ClimbSnail/SnailHeater/Doc/other.md

### 华为24V电源
原24V的R16为4322（43.2k）
20V的R16为2702（27k）

### 电源纹波
华为5.284  5.295v  空载浮动0.015
普通 5.292 5.304v  空载浮动0.016

### SnailHeater
接负载3A

---
##### 第一次
可调电源
［24V电源输入端］
空载: 230mv
1A 240mv
2A 280mv
3A 350mv
4A 370mv
5A 700mv

[可调电源输出端]
空载: 40mv
1A 60mv
2A 60mv
3A 70mv
4A 140mv
5A 150mv

---
##### 第二次
100mv  20ms

输入电源
空载 330mv
9V3A 500mv

可调电源
空载 230mv
9V3A  300mv

### 磁铁触发测试
* 6*10mm 左右各两个（共4个），完全能触发，但底座不能完美安装上。
* 6*10mm 左右各一个（共2个），80%角度都能触发，能安装上。
* 6*15mm 左右各一个，能完美安装且完全能触发。
* 8*12mm 左右各一个，能完美安装且完全能触发。
* 15*3mm圆形磁铁左右各一个，能完美安装且完全能触发。

### 烙铁架
* 原烙铁架 70*160mm
* 现烙铁架 73*160mm

### 组装注意事项
【电源板】
1. 背面标有“填锡孔”字样的孔需要用锡填充。
2. 侧边贴外壳的三脚的二极管，需要事先调好高度。(组装需要拧螺丝)
3. 板子上插接的小电源需要使用绝缘胶固定。
4. 插件的小电源旁边有个位号“SB3”的短接焊盘，需要短接上。
5. 注意电源输出端子的连接线，GND黑色，24V红色，12v白色

【屏幕板】
1. 康铜丝跳线器件焊接的时候 顶端需要比板子边缘略高一点点，1mm左右就行
2. 旋钮编码器需要弯脚，然后焊接在屏幕板上

【驱动板】
1. 背面标有“填锡孔”字样的孔需要用锡填充。

【接线板】
1. 板子是两部分，中间需要掰开（最好用剪线钳压一下，避免掰坏铜皮）。一个是类似方形的小板，另一部分是长条形的。
2. 两个GX16-8航空头中间的第8脚都需要用2.5cm的硅胶线连接到各自附近的通孔上。

【组装注意】
1. 机壳的青稞纸不要盖住螺丝孔位。
2. 驱动板的两个可控硅，需要通过垫氧化铝散热片以及绝缘粒方可拧上螺丝。
3. 驱动板与机壳安装时，驱动板右上角固定螺丝不要拧太紧（容易让板子变形）。拧上螺丝后需要打点胶固定螺丝。
4. 驱动板的220V接线座，拧完螺丝后，最好在螺丝上打点胶，以免螺丝运输过程中松动。

### 加热台发热芯要求
1. 把1234号孔心距边缘5mm
2. 1、2号孔相距13cm  3、4号孔也是1、3cm
3. 1、3号孔相距8cm  2、4号孔也是8cm

然后不要打金黄色的固定环  固定的话用订书钉就行

### 烙铁分度表
注：ZT-X万用表实测电压比以下高10mv左右。以下电压均为热电偶放大201倍后的电压
##### JBC245-759 单次实测
温度 | 5 | 10 | 15 | 20 | 25 | 30 | 35 | 40 | 45 | 50 | 55 | 60 | 65 | 70 | 75 | 80 | 85 | 90 | 95 | 100
:-: | :-: | :-: | :-: | :-: | :-: | :-: | :-: | :-: | :-: | :-: | :-: | :-: | :-: | :-: | :-: | :-: | :-: | :-: | :-: | :-:
0 | 5 | 5 | 5 | 5 | 5 | 5 | 5 | 5 | 5 | 5 | 5 | 5 | 5 | 5 | 5 | 5 | 5 | 5 | 5 | 5
100 | 5 | 5 | 5 | 5 | 5 | 5 | 5 | 5 | 5 | 5 | 5 | 5 | 5 | 5 | 5 | 5 | 5 | 5 | 5 | 5
200 | 5 | 5 | 5 | 5 | 5 | 5 | 5 | 5 | 5 | 5 | 5 | 5 | 5 | 5 | 5 | 5 | 5 | 5 | 5 | 5
300 | 5 | 5 | 5 | 5 | 5 | 5 | 5 | 5 | 5 | 5 | 5 | 5 | 5 | 5 | 5 | 5 | 5 | 5 | 5 | 5
400 | 5 | 5 | 5 | 5 | 5 | 5 | 5 | 5 | 5 | 5 | 5 | 5 | 5 | 5 | 5 | 5 | 5 | 5 | 5 | 5
500 | 5 | 5 | 5 | 5 | 5 | 5 | 5 | 5 | 5 | 5 | 5 | 5 | 5 | 5 | 5 | 5 | 5 | 5 | 5 | 5

##### JBC245-759 稳定实测
温度 | 50 | 100 | 150 | 200 | 250 | 300 | 350 | 400 | 450
:-: | :-: | :-: | :-: | :-: | :-: | :-: | :-: | :-: | :-: 
C245-908 | 88 | 333 | 580 | 840 | 1100 | 1375 | 1663 | 1930 | 2160
C245-759 | 94 | 347 | 597 | 863 | 1138 | 1410 | 1680 | 1945 | 
C210-006 | 42 | 129 | 225 | 343 | 450 | 574 | 700 | 826 | 959
