ClimbSnail/SnailHeater/Doc/重量统计.md

高频焊台总共1350g

#### 外壳 228g
#### pcba（不含线） 75.9g

#### 整体主机 537.1g

#### 风枪手柄 220g
#### 风枪架 46.4g

#### 加热板: 
* 上板 242g 
* 下板58g 
* 发热心45.4g 
* 4套大螺丝（含螺母）60g  
* 7枚小螺丝6.1g  
* 4个木墩5.2g
* 热电偶4g

#### 烙铁:
* JBC245烙铁芯6g
* T12烙铁芯7.3g
* JBC210烙铁芯2.2g
* JBC245手柄65.3g(含1.3m线、航空插)
* T12手柄77.5g（含1.2m线、航空插）
* JBC210手柄15.9g（不含线和航空头）

#### 点焊机
* 3000UF*2电容  1010g

#### 24V大电源  146g
