ClimbSnail/SnailHeater/Tool/SnailManager/tools/README.md

# 独立工具

这些脚本不属于四个 GUI 入口的运行依赖，可按需单独执行。

- `cli/SnailHeater_Tool.py`：命令行刷机工具实现；建议从根目录的兼容入口启动。
- `wallpaper/createWallpaperClean.py`：生成空白壁纸文件。
