ClimbSnail/SnailHeater/Tool/SnailManager/requirements/requirements_webui_venv.txt

Pillow~=9.5.0
pyserial~=3.5
pyyaml==6.0
requests==2.26.0
pyinstaller==5.5.0
esptool==4.7.0
setuptools==49.2.1

# 现代 WebUI 本地服务与 Windows 容器
fastapi>=0.115,<1
uvicorn>=0.30,<1
pywebview>=5.4,<7
pypng==0.20220715.0
lz4==4.3.3
# MP4 转 RTTTL：沿用旧版 pYIN 音高检测与 BPM 量化算法
numpy==1.24.4
# librosa==0.10.2.post1
# QT_Tool 保留的独立 MIDI → RTTTL 转换脚本
mido==1.3.3
