ClimbSnail/SnailHeater/Tool/SnailManager/requirements/requirements_pyside_py38_venv.txt

altgraph==0.17.5
bitarray==3.8.0
bitstring==4.4.0
certifi==2026.2.25
cffi==1.17.1
charset-normalizer==2.0.12
cryptography==46.0.6
ecdsa==0.19.2
esptool==4.7.0
idna==3.11
intelhex==2.3.0
packaging==26.0
pefile==2024.8.26
Pillow==9.5.0
pyinstaller==5.5
pyinstaller-hooks-contrib==2026.3
pyserial==3.5
PySide2==5.15.2.1
pywin32-ctypes==0.2.3
PyYAML==6.0
reedsolo==1.7.0
requests==2.26.0
shiboken2==5.15.2.1
six==1.17.0
tibs==0.5.7
typing_extensions==4.13.2
urllib3==1.26.20
fastapi>=0.115,<1
uvicorn>=0.30,<1
pywebview>=5.4,<7
pypng==0.20220715.0
lz4==4.3.3

# MP4 转 RTTTL：沿用旧版 pYIN 音高检测与 BPM 量化算法
# numpy==1.24.4
# librosa==0.10.2.post1
# QT_Tool 保留的独立 MIDI → RTTTL 转换脚本
mido==1.3.3
