ClimbSnail/SnailHeater/Tool/QT_Tool/ToRtttl.md

## 转码须知
RTTTL和MIDI文件都不是音频编码文件，无法从mp3、wav等无损转化。

使用RTTTL的人较少，由于玩音乐钢琴的人多，故使用MIDI会多。

MIDI可以接近无损转为RTTTL（损失部分本身就是rtttl不支持的），可将wav、mp3文件先转成MIDI文件，然后再将MIDI转RTTTL。

## 可以直接下载现成的RTTTL文件
1. https://rtttl.ringtone.cc 最全的RTTTL铃声库
2. http://www.projectrtttl.com 老牌RTTTL网站，资源丰富
3. https://1j01.github.io/rtttl.js/ 
4. http://microblocks.fun/mbtest/NokringTunes.txt

##### 现成的RTTTL文本
* 诺基亚经典铃声 Nokia:d=4,o=5,b=180:8e6,8d6,f#,g#,8c#6,8b,d,e,8b,8a,c#,e,a
* 超级马里奥主题曲（片段） Mario:d=4,o=5,b=100:16e6,16e6,32p,8e6,16c6,8e6,8g6,8p,8g
* 小星星 Twinkle:d=4,o=5,b=120:8c,8c,8g,8g,8a,8a,4g,8f,8f,8e,8e,8d,8d,4c
* 生日快乐 Birthday:d=4,o=5,b=125:8c,8c,8d,8c,8f,8e,4c,8c,8c,8d,8c,8g,8f
* 简单蜂鸣器测试音 Test:d=4,o=5,b=60:8c5,8d5,8e5,8f5,8g5,8a5,8b5,8c6

## 可以直接下载现成的MIDI文件
1. MidiWorld (midiworld.com) 全球最大MIDI库之一，超过10万首，直接下载，无需注册
2. BitMidi (bitmidi.com) 现代界面，易搜索，完全免费，无下载限制
3. 

## Rtttl播放测试
1. https://github.com/ImSkully/rtttl-web-composer 项目自带的 https://rtttl.skully.tech/ web页面可以播放和编辑
2. https://github.com/adamonsoon/rtttl-play 开源项目可直接运行，但源码有点问题，需要根据Issues中参考修改，或者使用已经修改好的代码包

## MIDI文件测试播放
任意视频播放器均可
