ClimbSnail/SnailHeater/Doc/V2.0功率板修改/功率板电容原始状态.jpg

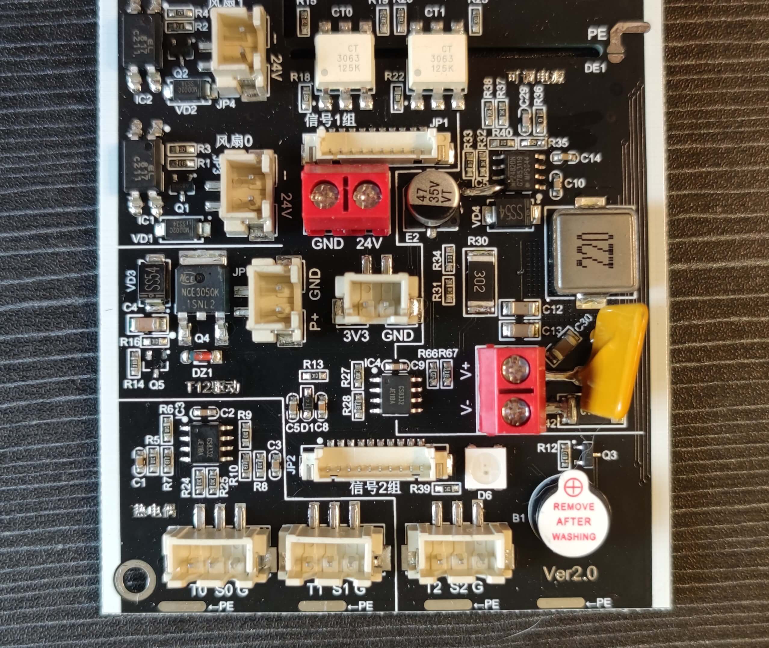
Doc/V2.0功率板修改/功率板电容原始状态.jpg
