ClimbSnail/SnailHeater/Doc/V2.0功率板修改/电容刮阻焊.jpg

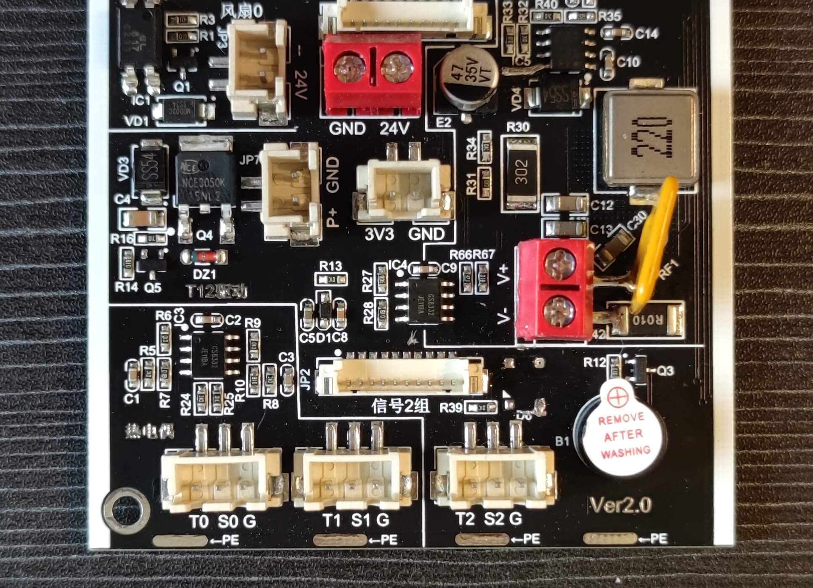
Doc/V2.0功率板修改/电容刮阻焊.jpg
