ClimbSnail/SnailHeater/Doc/V2.0功率板修改/电容焊接状态.jpg

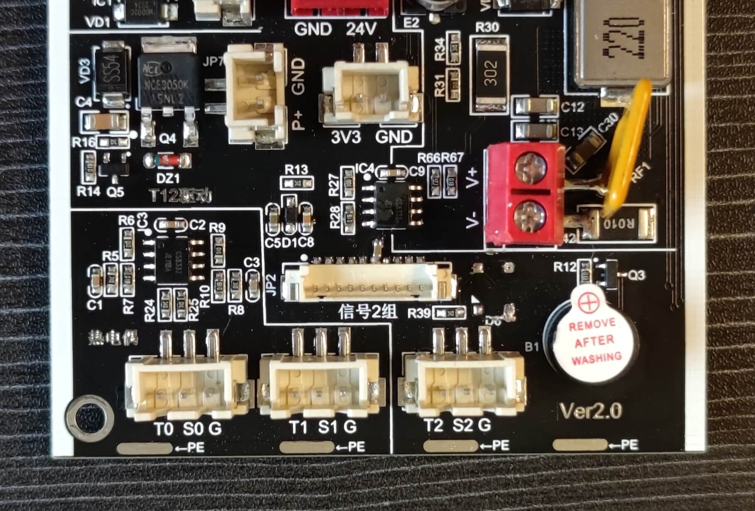
Doc/V2.0功率板修改/电容焊接状态.jpg
