ClimbSnail/SnailHeater/Doc/二车青稞纸定制.png

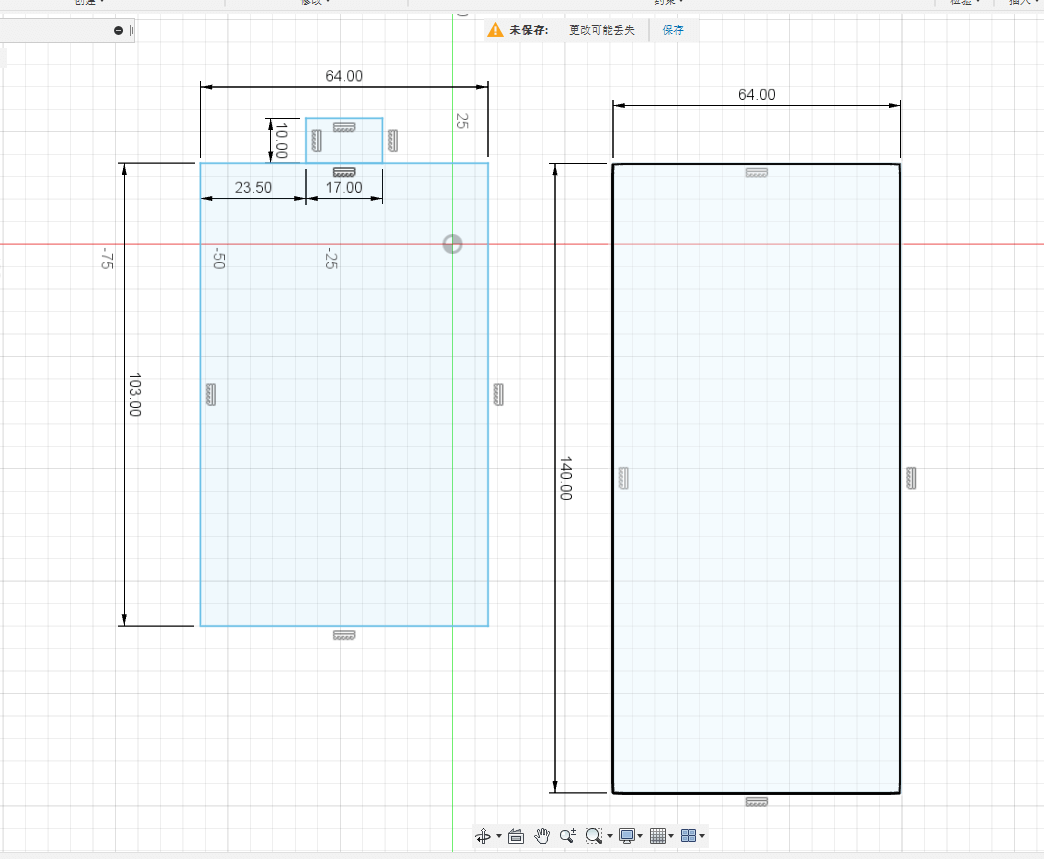
Doc/二车青稞纸定制.png
