ClimbSnail/SnailHeater/Doc/蜗牛台使用说明书/配套管理工具.png

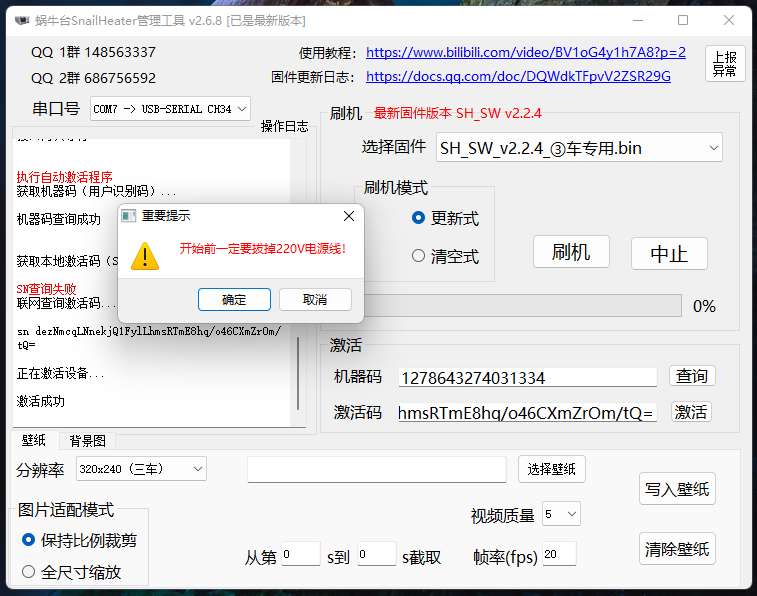
Doc/蜗牛台使用说明书/配套管理工具.png
