ClimbSnail/SnailHeater/Images/ico/方波-01.png

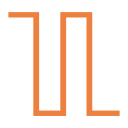
Images/ico/方波-01.png
