ClimbSnail/SnailHeater/Images/ico/正弦线.png

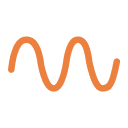
Images/ico/正弦线.png
