ClimbSnail/SnailHeater/Images/SnailHeaterUI_Simulator.png

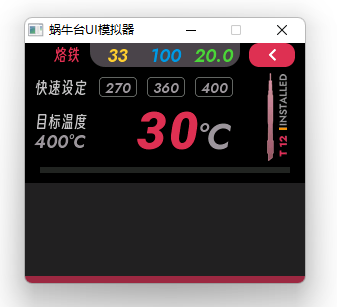
Images/SnailHeaterUI_Simulator.png
