ClimbSnail/SnailHeater/Images/全套控制板.jpg

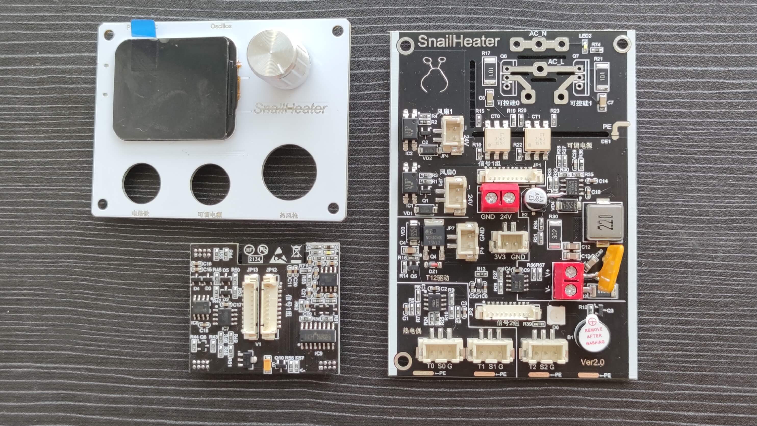
Images/全套控制板.jpg
