ClimbSnail/SnailHeater/Images/整机俯视图.jpg

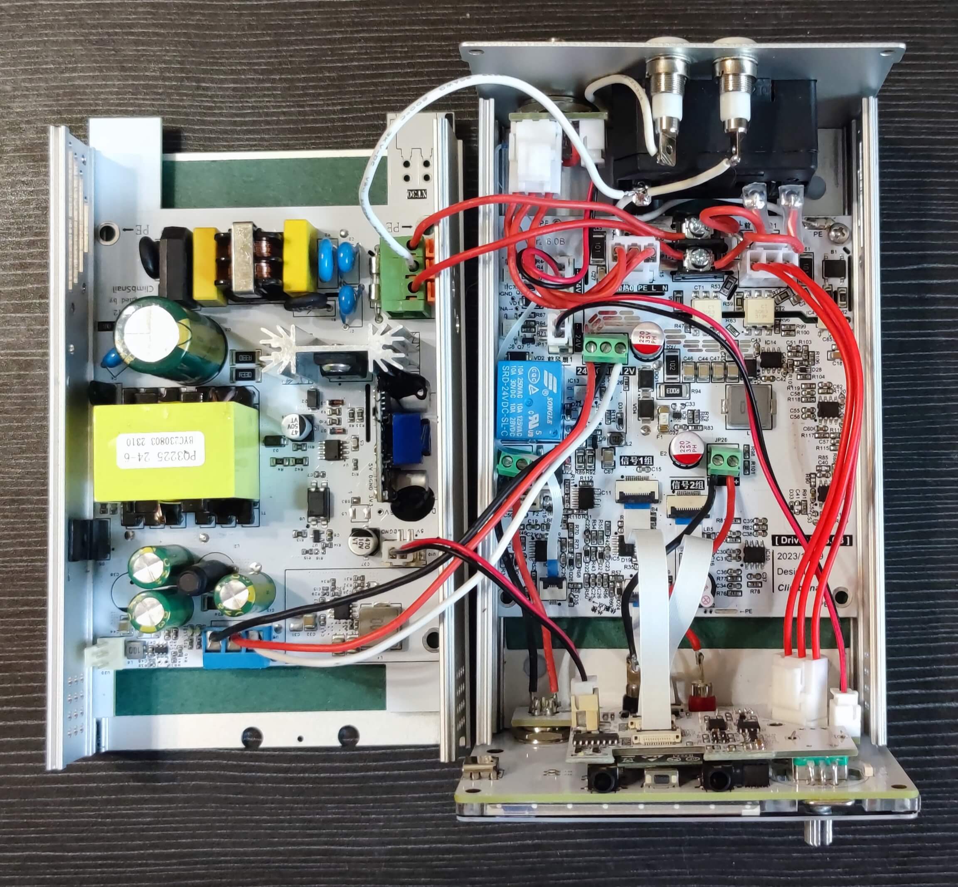
Images/整机俯视图.jpg
