ClimbSnail/SnailHeater/Images/面板图标元素/hotair_b.png

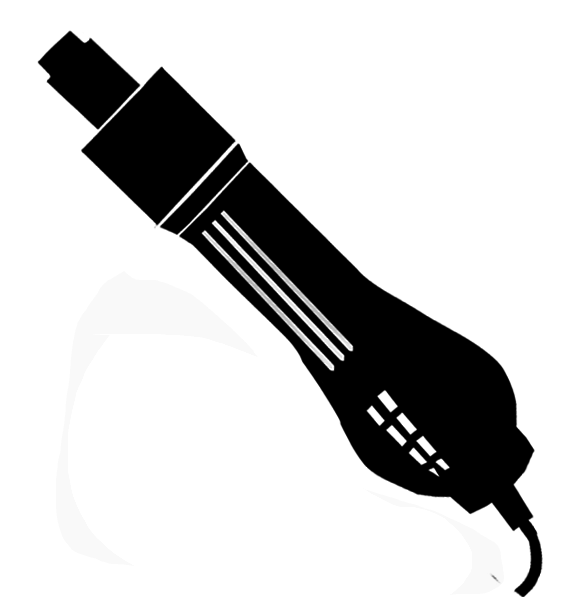
Images/面板图标元素/hotair_b.png
