ClimbSnail/SnailHeater/Images/面板图标元素/hotair_w.png

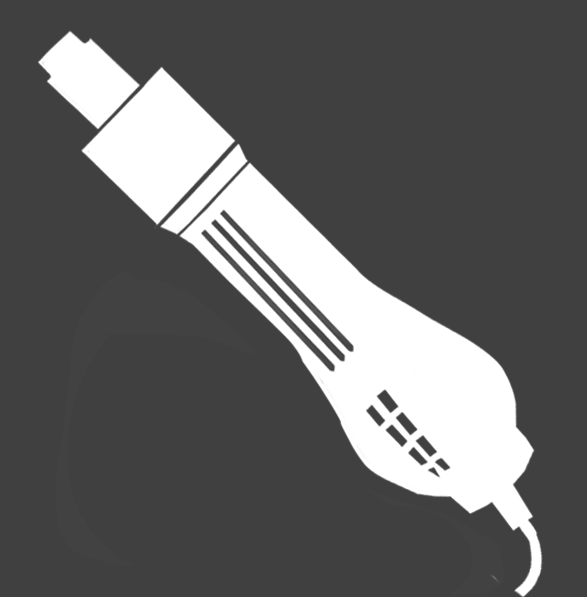
Images/面板图标元素/hotair_w.png
