ClimbSnail/SnailHeater/Images/面板图标元素/osc_b.png

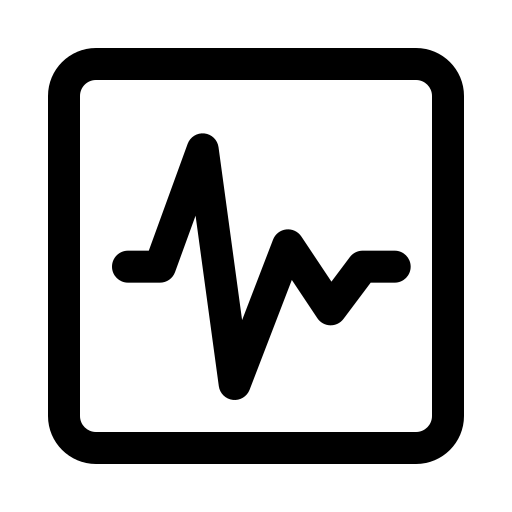
Images/面板图标元素/osc_b.png
