ClimbSnail/SnailHeater/Images/面板图标元素/osc_w.png

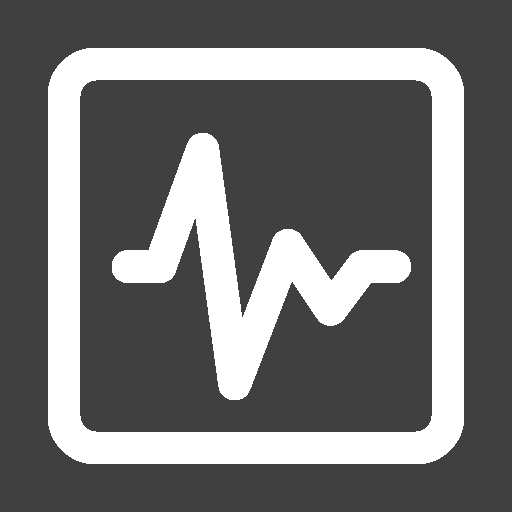
Images/面板图标元素/osc_w.png
