ClimbSnail/SnailHeater/Images/面板图标元素/pwm_b.png

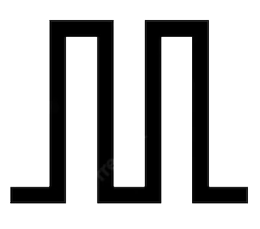
Images/面板图标元素/pwm_b.png
