ClimbSnail/SnailHeater/Images/面板图标元素/pwm_w.png

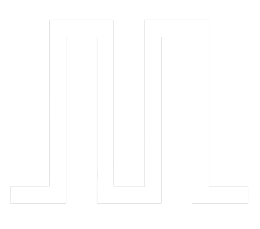
Images/面板图标元素/pwm_w.png
