ClimbSnail/SnailHeater/Tool/SnailManager/images/climbsnail_big.jpg

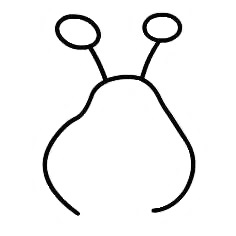
Tool/SnailManager/images/climbsnail_big.jpg
