ClimbSnail/SnailHeater/Tool/SnailManager/images/SnailHeater_256.jpg

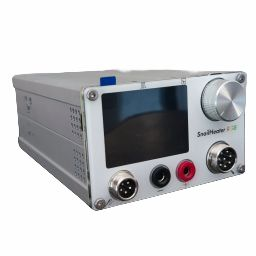
Tool/SnailManager/images/SnailHeater_256.jpg
