ClimbSnail/SnailHeater/Tool/SnailManager/lvgl_image_converter/images/aBoy.jpg

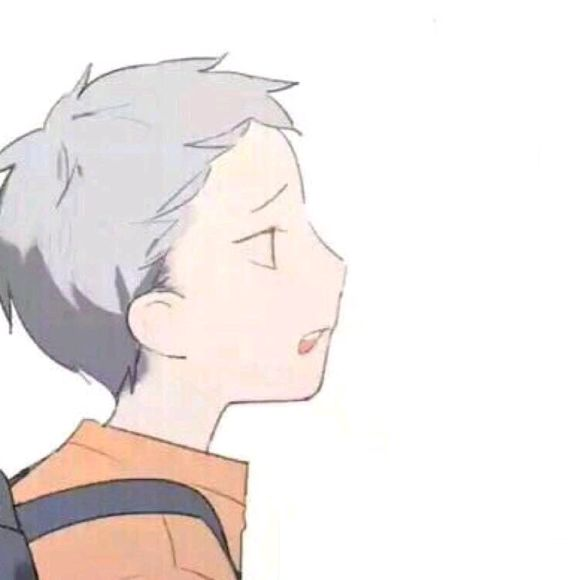
Tool/SnailManager/lvgl_image_converter/images/aBoy.jpg
