ClimbSnail/SnailHeater/Tool/SnailManager/lvgl_image_converter/images/May.png

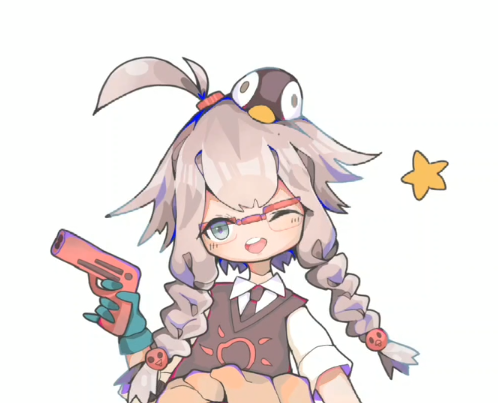
Tool/SnailManager/lvgl_image_converter/images/May.png
