ClimbSnail/SnailHeater/Tool/SnailManager/lvgl_image_converter/images/second/Lapland_and_Texas.png

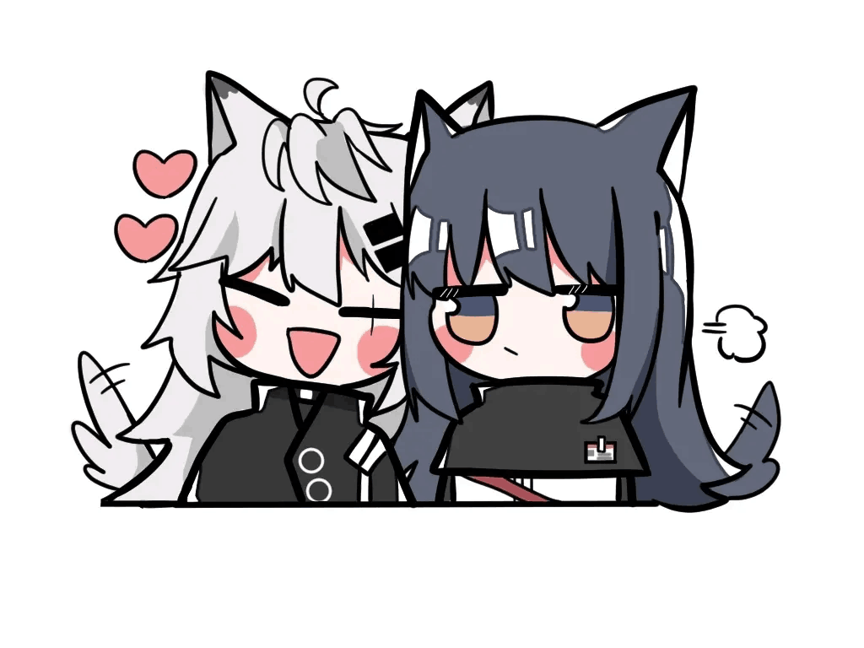
Tool/SnailManager/lvgl_image_converter/images/second/Lapland_and_Texas.png
