ClimbSnail/SnailHeater/Images/面板图标元素/snailHeater字样.dxf

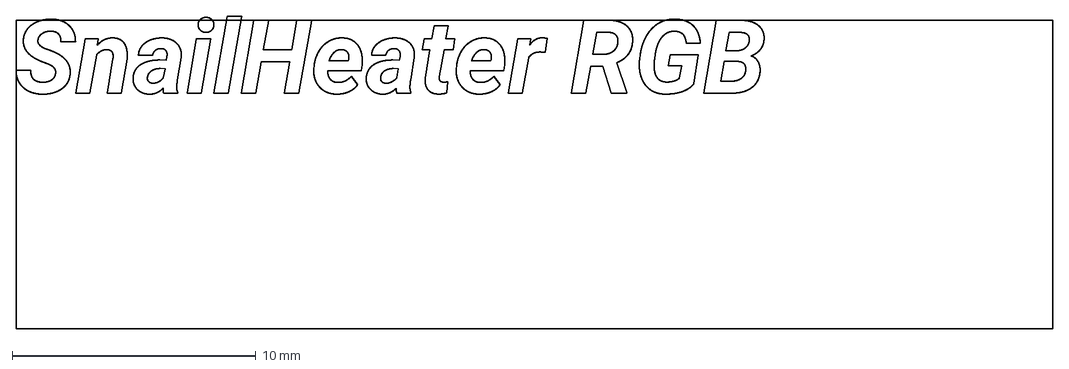
[picture p58: CAD file, 2024-01-15]
Images/面板图标元素/snailHeater字样.dxf
42.6 x 12.8 mm
