ClimbSnail/SnailHeater/Model/屏幕辅助贴合固定板 v1.stl

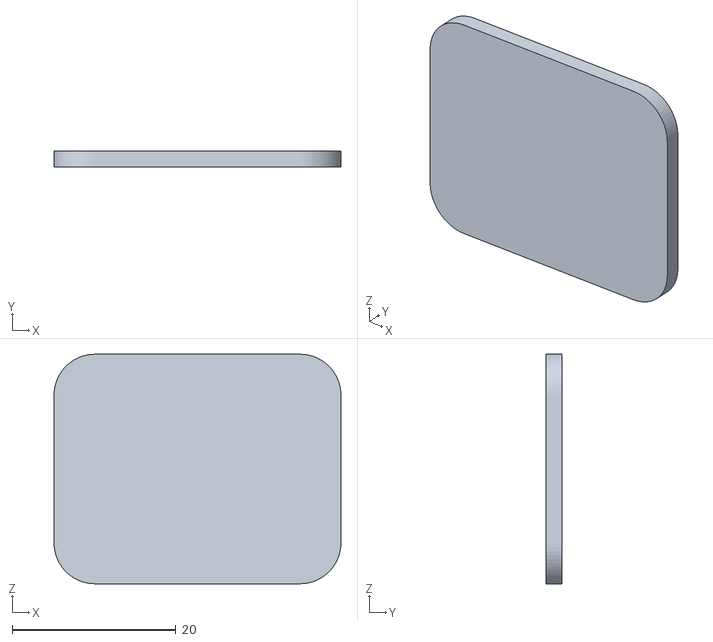
[picture p59: CAD file, 2023-03-16]
Model/屏幕辅助贴合固定板 v1.stl
35.0 x 2.00 x 28.0
