ClimbSnail/SnailHeater/Model/SnailHeater电源支架 v6.stl

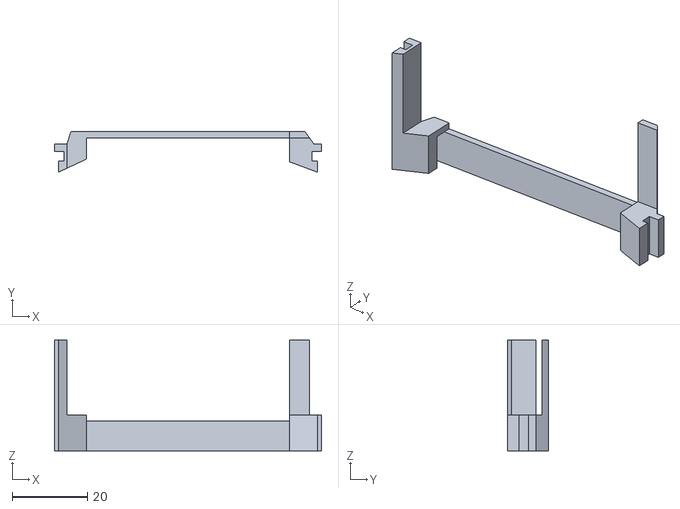
[picture p60: CAD file, 2023-03-16]
Model/SnailHeater电源支架 v6.stl
71.0 x 10.8 x 29.5
