ClimbSnail/SnailHeater/Images/面板图标元素/solder.png

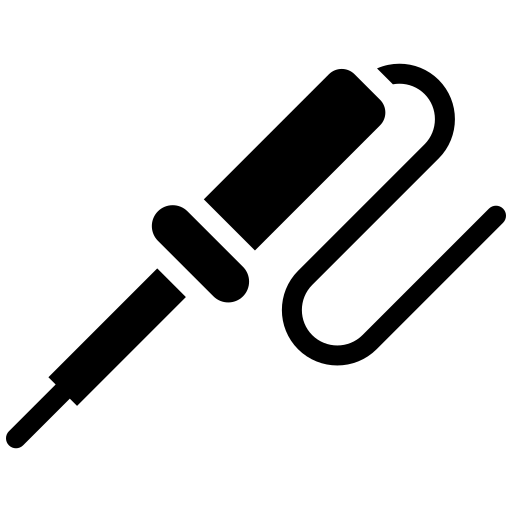
Images/面板图标元素/solder.png
