ClimbSnail/SnailHeater/Images/面板图标元素/solder_w.png

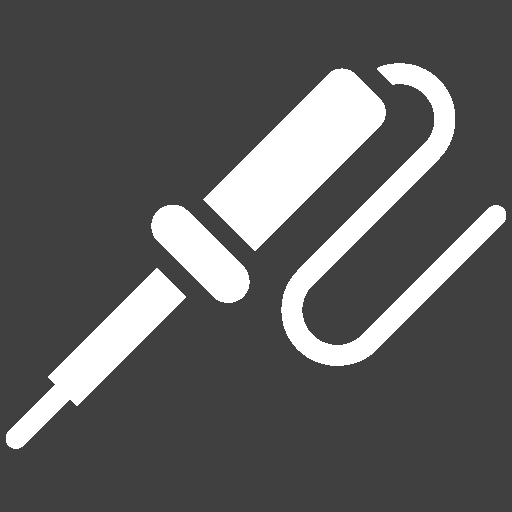
Images/面板图标元素/solder_w.png
