ClimbSnail/SnailHeater/(list of files, drawings)

Other design files:
Hardware/ExtendBoard/ExtendBoard.PcbDoc
Multisim/mos分压.ms14
Multisim/拉高电阻干扰处理.ms14
Multisim/滤波.ms14
Multisim/烙铁mos管驱动.ms14
Multisim/烙铁电压切换.ms14
