ClimbSnail/SnailHeater/Tool/SnailManager/SnailHeater_Tool.yaml

# 本行为yaml文件注释范例
# yaml配置格式以空格缩进区分层级关系
# key后面紧跟一个冒号 冒号后需加一个空格方可填写value

windows_tool:
  
  # 本工具模板地址
  tool_open_url: "本工具开源地址：https://github.com/ClimbSnail/esp_win_tool"

  # 工具的名称
  tool_name: "蜗牛台SnailHeater管理工具 "
  
  # 自定义QQ群信息 一共需填写两个群号，中间英文的分号隔开
  qq_info: QQ_1群 148563337,QQ_2群 686756592
  
  # 自定义额外的视频或文档链接
  info_url_0:
    name: 使用教程
    url: "https://www.bilibili.com/video/BV1oG4y1h7A8?p=2"
  info_url_1:
    name: 更新日志
    url: "https://docs.qq.com/doc/DQWdkTFpvV2ZSR29G"
  
  # 下载的波特率
  baud_rate: "921600"
  # 通讯的波特率
  info_baud_rate: "921600"
  # 主固件的目录
  # main_appdir_rules: "../蜗牛台管理工具v2.8.7（含v2.6.0固件）/"
  main_appdir_rules: ./
  # main_app_rules 为页面搜索框中搜索主程序的适配规则
  # 下面的匹配规则（正则表达式）
  # main_app_rules: SH_SW_v\S*\.bin
  main_app_rules: (SnailHeater_v|SH_SW_v)\S*\.bin

  # 预留的读取激活码的本地缓存文件 用于不在联网状态下使用（本字段需要配合固件联调）
  temp_sn_recode_path: temporary_sn_recode.txt
  
  # 激活码以及注册者信息查询的api 需要激活码管理员有服务器 
  search_sn_registrant_url: http://climbsnail.cn/api/v1/snailheater/sn/
  # 获取最新固件版本的api
  get_firmware_new_ver_url: http://climbsnail.cn/api/v1/snailheater/firmware/version
  # 获取最新工具版本的api
  get_tool_new_ver_url: http://climbsnail.cn/api/v1/snailheater/tool/version
  # coredump文件上传的地址
  coredump_upload_url: http://climbsnail.cn/api/v1/coredump
  # 自动激活的api 用于工厂批量生产（应设超级权限）
  # activate_sn_url: http://climbsnail.cn/api/v1/snailheater/sn/new/

  # search_sn_registrant_url: http://127.0.0.1:5001/api/v1/snailheater/sn/
  # get_firmware_new_ver_url: http://127.0.0.1:5001/api/v1/snailheater/firmware/version
  # get_tool_new_ver_url: http://127.0.0.1:5001/api/v1/snailheater/tool/version

sn_tool:
  # 蜗牛台数据库(保存激活过的激活码路径)
  snail_db_path: "../../snail.sqlite3"

# 配置服务端的配置文件 
sn_search_server:
  config_name: sn_search_server_prod
  # config_name: sn_search_server_dev
  # config_name: sn_search_server_test

# OTA存储方式选择 ftp / oss
sn_ota_provider:
  # provider: ftp
  provider: oss

# 站点展示配置
site_info:
  site_name_zh: "蜗牛科技"
  site_name_en: "Snail Technology"
  supported_locales:
    - zh
    - en
  default_locale: "zh"
  icp_number: "京ICP备2023022919号-1"
  copyright_owner: "北京攀爬蜗牛科技中心"
  
# 生产环境服务器配置
sn_search_server_prod:
  # 蜗牛台数据库
  snail_db_path: ./snail.sqlite3
  # 读取的SH_TOOL所支持的固件版本
  tool_supports_info_path: ./tool_supports_info.txt
  # server启动绑定的服务器ip
  server_ip: "0.0.0.0"
  # server启动绑定的服务器端口
  server_http_port: 5001
  server_https_port: 5002
  https_cert: ./server_cert.pem
  # https的私钥
  https_key: ./server_key.pem
  ota_dir: 
    root: ./ota
    snailheater: ./ota/ota_snailheater
    sel: ./ota/ota_sel
    fan: ./ota/ota_fan
    led: ./ota/ota_led
  # OSS配置（仅oss模式下生效）
  oss:
    # 需要在ESA中配置记录值 oss-xxx，ESA中设置回源"跟随源站域名"。
    # 之后在DNS中配置ESA提供的记录值
    # 使得访问oss-public.climbsnail.cn可以访问到climbsnail-xxx.oss-cn-beijing.aliyuncs.com
    ota_url_header: "http://oss-public.climbsnail.cn"
    images_url_header: "http://oss-public.climbsnail.cn/images"
    avater_url_header: "http://oss-public.climbsnail.cn/avater"
    bucket_pub: "climbsnail-public"

    db_backup_url_header: "http://oss-private.climbsnail.cn/db_backup"
    bucket_private: "climbsnail-private"
    
    endpoint: "oss-cn-beijing.aliyuncs.com"
  # ftp服务的URL
  ftp_url_header: "http://ftp.climbsnail.cn"
  ftps_url_header: "https://ftp.climbsnail.cn"
  # ftp启动绑定的服务器端口
  ftp_port: 5003
  ftps_port: 5004

  # mqtt的配置
  mqtt_uri: climbsnail.cn
  mqtt_port: 1883
  mqtt_username: ClimbSnail
  mqtt_password: ClimbSnail.v0
  mqtt_clientID: Server
  # 管理器的启动消息
  mqtt_manager_topic: /snail/manager
  # 要检测的焊台活动主题
  mqtt_subscribe: /snail/+/+
  # 要推送的topic
  mqtt_action_topic: /snail/action

# 开发环境服务器配置
sn_search_server_dev:
  # 蜗牛台数据库
  snail_db_path: ./snail.sqlite3
  # 读取的SH_TOOL所支持的固件版本
  tool_supports_info_path: ./tool_supports_info.txt
  # server启动绑定的服务器ip
  server_ip: "0.0.0.0"
  # server启动绑定的服务器端口
  server_http_port: 5011
  server_https_port: 5012
  https_cert: ./server_cert.pem
  # https的私钥
  https_key: ./server_key.pem
  ota_dir: 
    root: ./ota
    snailheater: ./ota/ota_snailheater
    sel: ./ota/ota_sel
    fan: ./ota/ota_fan
    led: ./ota/ota_led
  # OSS配置（仅oss模式下生效）
  oss:
    # 需要在ESA中配置记录值 oss-xxx，ESA中设置回源"跟随源站域名"。
    # 之后在DNS中配置ESA提供的记录值
    # 使得访问oss-public.climbsnail.cn可以访问到climbsnail-xxx.oss-cn-beijing.aliyuncs.com
    ota_url_header: "http://oss-public.climbsnail.cn"
    images_url_header: "http://oss-public.climbsnail.cn/images"
    avater_url_header: "http://oss-public.climbsnail.cn/avater"
    bucket_pub: "climbsnail-public"

    db_backup_url_header: "http://oss-private.climbsnail.cn/db_backup"
    bucket_private: "climbsnail-private"
    
    endpoint: "oss-cn-beijing.aliyuncs.com"
  # ftp服务的URL
  ftp_url_header: "http://ftp.dev.climbsnail.cn"
  ftps_url_header: "https://ftp.dev.climbsnail.cn"
  # ftp启动绑定的服务器端口
  ftp_port: 5013
  ftps_port: 5014

  # mqtt的配置
  mqtt_uri: climbsnail.cn
  mqtt_port: 1883
  mqtt_username: ClimbSnail
  mqtt_password: ClimbSnail.v0
  mqtt_clientID: Server
  # 管理器的启动消息
  mqtt_manager_topic: /snail/manager
  # 要检测的焊台活动主题
  mqtt_subscribe: /snail/+/+
  # 要推送的topic
  mqtt_action_topic: /snail/action


# 本地环境服务器配置
sn_search_server_test:
  # 蜗牛台数据库
  snail_db_path: D:/Workspace/OpenWorkspace/PersionSnailHeater/snail.sqlite3
  # 读取的SH_TOOL所支持的固件版本
  tool_supports_info_path: ./tool_supports_info.txt
  # server启动绑定的服务器ip
  server_ip: "0.0.0.0"
  # server启动绑定的服务器端口
  server_http_port: 5001
  server_https_port: 5002
  https_cert: ./server_cert.pem
  # https的私钥
  https_key: ./server_key.pem
  ota_dir: 
    root: ./ota
    snailheater: ./ota/ota_snailheater
    sel: ./ota/ota_sel
    fan: ./ota/ota_fan
    led: ./ota/ota_led
  # OSS配置（仅oss模式下生效）
  oss:
    # 需要在ESA中配置记录值 oss-xxx，ESA中设置回源"跟随源站域名"。
    # 之后在DNS中配置ESA提供的记录值
    # 使得访问oss-public.climbsnail.cn可以访问到climbsnail-xxx.oss-cn-beijing.aliyuncs.com
    ota_url_header: "http://oss-public.climbsnail.cn"
    images_url_header: "http://oss-public.climbsnail.cn/images"
    avater_url_header: "http://oss-public.climbsnail.cn/avater"
    bucket_pub: "climbsnail-public"

    db_backup_url_header: "http://oss-private.climbsnail.cn/db_backup"
    bucket_private: "climbsnail-private"
    
    endpoint: "oss-cn-beijing.aliyuncs.com"
  # ftp服务的URL
  ftp_url_header: "http://127.0.0.1:5003"
  ftps_url_header: "https://127.0.0.1:5004"
  # ftp启动绑定的服务器端口
  ftp_port: 5003
  ftps_port: 5004

  # mqtt的配置
  mqtt_uri: climbsnail.cn
  mqtt_port: 1883
  mqtt_username: ClimbSnail
  mqtt_password: ClimbSnail.v0
  mqtt_clientID: Server
  # 管理器的启动消息
  mqtt_manager_topic: /snail/manager
  # 要检测的焊台活动主题
  mqtt_subscribe: /snail/+/+
  # 要推送的topic
  mqtt_action_topic: /snail/action
