ClimbSnail/SnailHeater/(commit log)

2021-10-02 add Controller_PCB
    [Controller_AC.PrjPcb, Controller_AC.SchDoc]
2021-10-02 add PCB
    [ExtendBoard.PcbDoc]
2021-10-30 md HW
    [Controller_AC.PrjPcb, Controller_AC.SchDoc, ExtendBoard.PrjPcb, ExtendBoard.SCHLIB, ExtendBoard.SchDoc]
2021-11-09 add code
    [partitions-no-ota.csv]
2021-11-18 md test
    [Controller_AC.PrjPcb, ExtendBoard.PrjPcb]
2022-03-27 更新驱动
2022-03-28 风枪加入PID控制
2022-05-01 完善驱动
2022-05-19 fix power
2022-05-20 添加线序
2022-07-11 updata readme
    [partitions-no-ota.csv]
2022-08-17 更新文档
2022-08-31 更新文档教程
2022-09-23 add QT_TOOL
    [pyvenv.cfg]
2022-11-04 添加希尔伯特曲线脚本
2023-02-20 add Multisim
    [滤波.ms14, 烙铁mos管驱动.ms14, 烙铁电压切换.ms14]
2023-03-16 md system info
    [SnailHeater电源支架 v6.stl, mos分压.ms14, 屏幕辅助贴合固定板 v1.stl, 拉高电阻干扰处理.ms14, 烙铁mos管驱动.ms14]
2023-03-24 md roller
    [拉高电阻干扰处理.ms14]
2023-03-27 忽略arcmenu
2023-04-22 Tool V2.4_R2
    [pyvenv.cfg]
2023-05-09 修复缩放
2023-06-22 update active
    [SnailHeater_WinTool.cfg]
2023-06-22 add log info
    [SnailHeater_SN.cfg, SnailHeater_WinTool.cfg]
2023-06-29 update active for factor mode
    [SnailHeater_WinTool.cfg]
2023-07-13 使用说明书修改格式
2023-07-26 记录热电偶分度表数据
2023-09-07 md 声明
2023-09-13 将原前面板修改为屏幕板
2023-09-13 add activate
    [SnailHeater_Tool.cfg, SnailHeater_WinTool.cfg]
2023-10-30 完善提示信息
2023-11-16 wallpaper supput bin file
    [JBC245分度表.xlsx]
2023-11-19 优化图标
2023-11-27 修复壁纸图片转化问题
2023-11-28 fix 默认壁纸问题
2023-11-28 fix 视频截取
2023-12-01 简化目录结构
2023-12-11 wallpaper image auto del
    [SnailHeater_Tool.cfg]
2023-12-31 优化图片过大时的提示
2024-01-14 更新介绍
2024-01-14 修改图片尺寸
2024-01-15 修改黑色面板元素
    [snailHeater字样.dxf]
2024-01-16 完善yaml文件
2024-02-06 忽略lock_screen
2024-02-06 规范文档资料
2024-02-06 添加引用
2024-02-11 优化文字提示
2024-03-23 优化运行在曲线模式下的加热台目标温度
2024-04-03 修改激活码获取说明
2024-04-18 add backgroud
    [SnailHeater_Tool.cfg, pyvenv.cfg]
2024-04-26 完善自动识别电阻说明
2024-04-27 优化提示信息
2024-04-27 优化一二车UI
2024-07-04 新增UI字体颜色修改
2024-07-05 优化比例缩放
2024-07-09 新增版本号查询
2024-07-12 新增无界面刷机工具
2024-07-14 完善图片裁剪的日志打印
2024-07-20 完善命令行刷机工具
2024-07-27 优化宽高比小于原视频的视频转化
2024-09-19 完善UI细节
2024-09-20 修复激活成功后的误报
2024-10-12 新增对S3版本的下载支持
2024-10-13 备份蓝星键盘刷机工具程序
2024-10-28 新增固件扫描路径的配置
2024-10-28 修复通讯波特率误删问题
2024-11-07 优化壁纸帧率
2024-11-10 更新式刷机修改为不对背景图、壁纸进行还原
2024-11-21 新增通用命令行工具
2025-03-13 优化脚本
2025-03-23 优化ProS3版本刷机闪退问题
2025-05-21 完善通信协议的帧头帧尾
2025-05-21 Lite版本优化通信协议的帧头帧尾
2025-09-18 补充说明
2025-12-17 新增对Rtttl的支持
2026-01-28 管理工具优化类型
2026-01-28 修改壁纸版本号、请求的timeout
2026-02-22 移除通用刷机工具
2026-02-25 新增电子负载刷机工具
2026-02-28 修改旧版本兼容性
2026-03-30 feat: 迁移到pyside2
2026-03-31 style: 优化esptool修改
2026-04-24 迁移EL上位机源码
2026-04-29 feat: 适配新的服务api
2026-05-15 doc: 修改构建的py版本
2026-05-22 feat: 优化主固件搜索匹配
2026-08-09 规范api
2026-08-19 doc: 删除用不上的旧文件
    [SnailHeater_SN.cfg, SnailHeater_WinTool.cfg]
2026-08-30 feat: 规范命名、新增coredump的读取
2026-08-31 feat: 新增pwm音频文件的生成
2026-09-02 feat: 新增pcm音频
2026-10-20 doc: 同步配置文件、文档
2026-10-31 feat: 修改电子负载的烧录地址
2026-11-02 doc: 补充环境
2026-11-03 doc: 修复macos构建脚本
2026-11-03 doc: 再次更改
